donpivo/BluetoothToAmAdapter/Pictures/V2/02.jpg

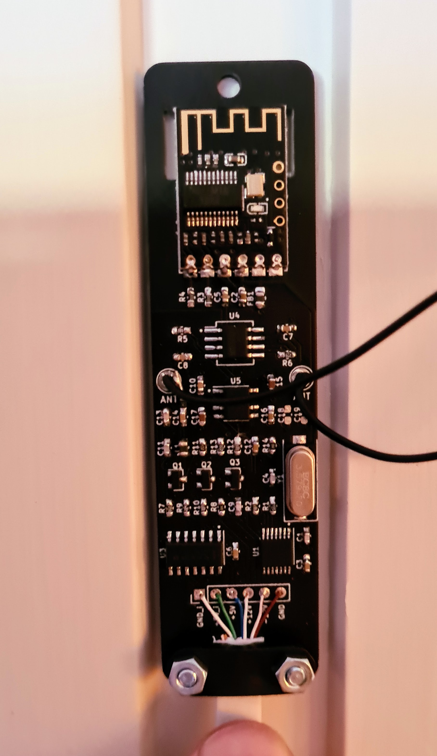
Pictures/V2/02.jpg
