donpivo/BluetoothToAmAdapter/Pictures/V2/6.jpg

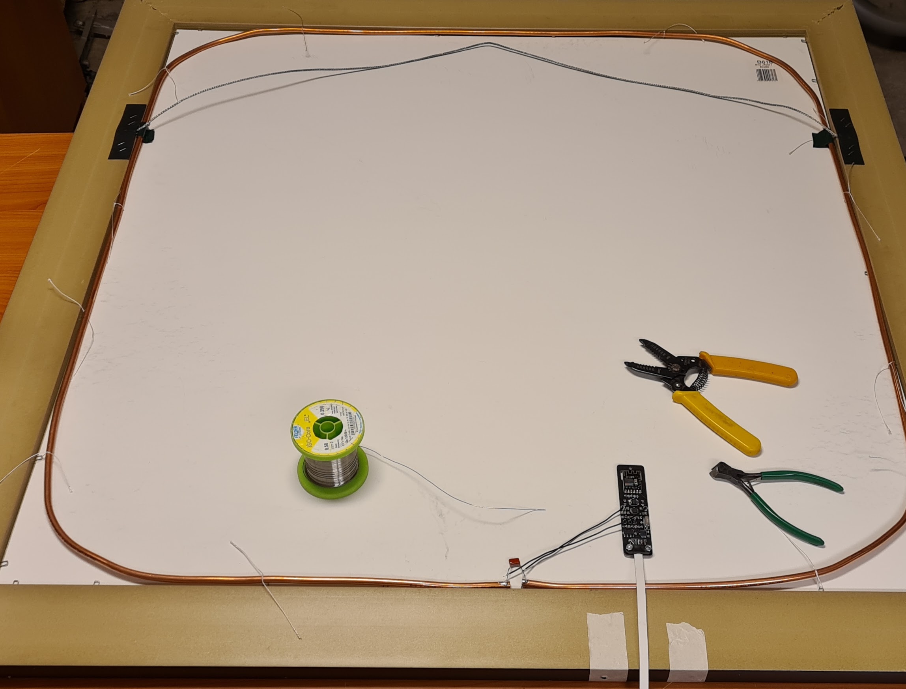
Pictures/V2/6.jpg
