donpivo/BluetoothToAmAdapter/Pictures/V2/01.jpg

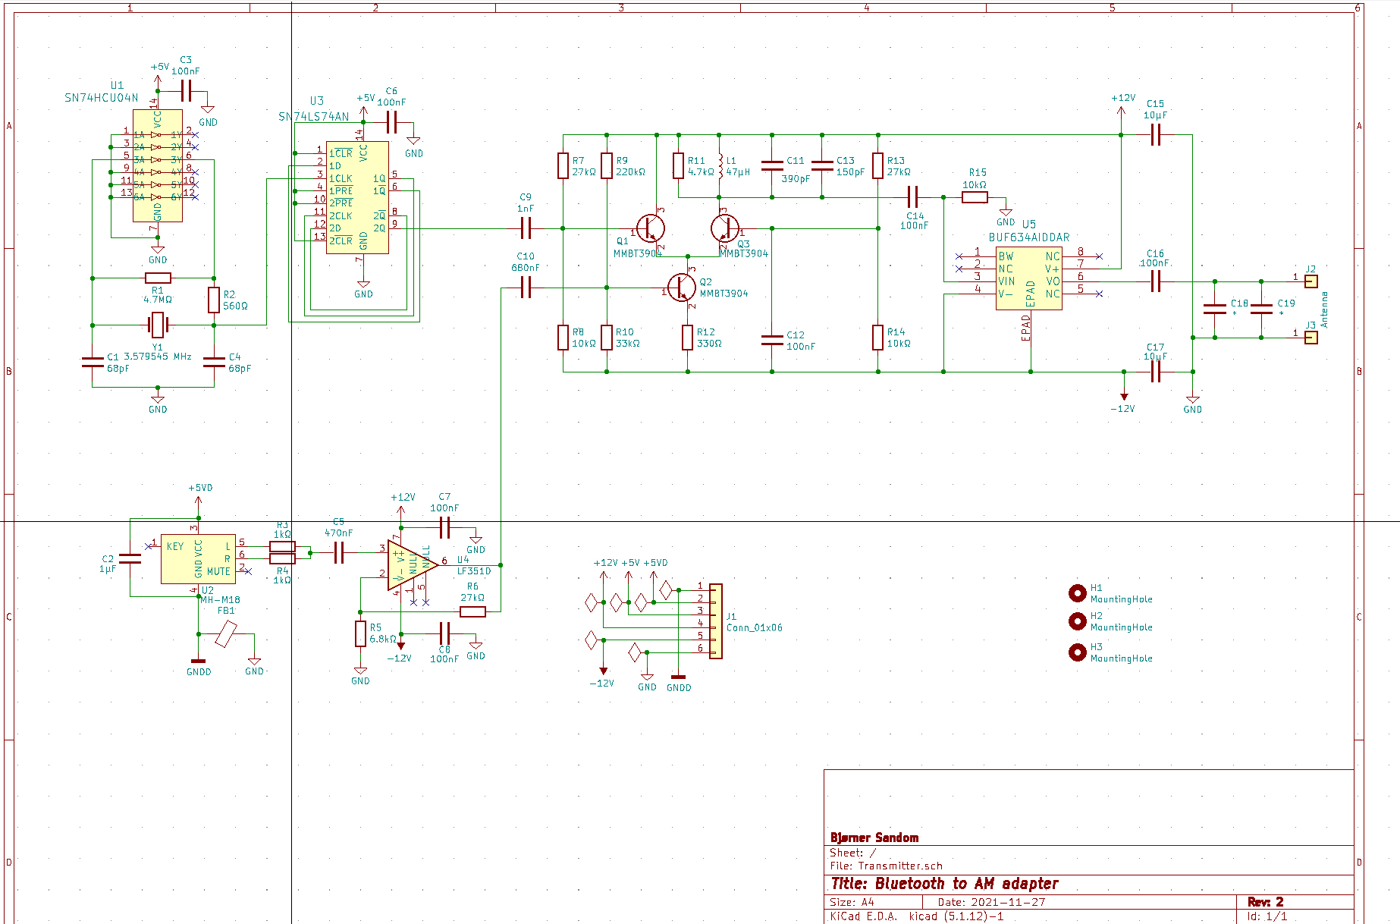
Pictures/V2/01.jpg
