donpivo/BluetoothToAmAdapter/Pictures/V2/03.jpg

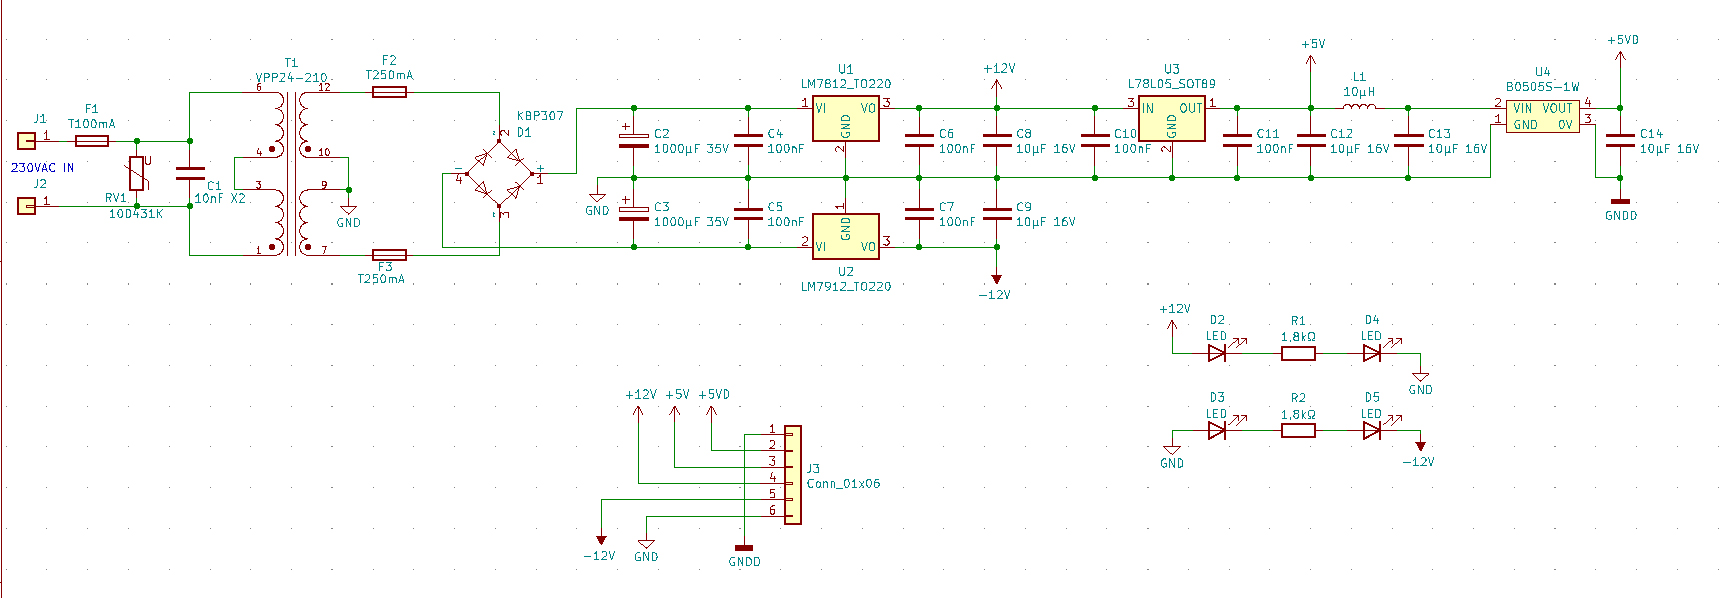
Pictures/V2/03.jpg
