donpivo/BluetoothToAmAdapter/Pictures/V2/04.jpg

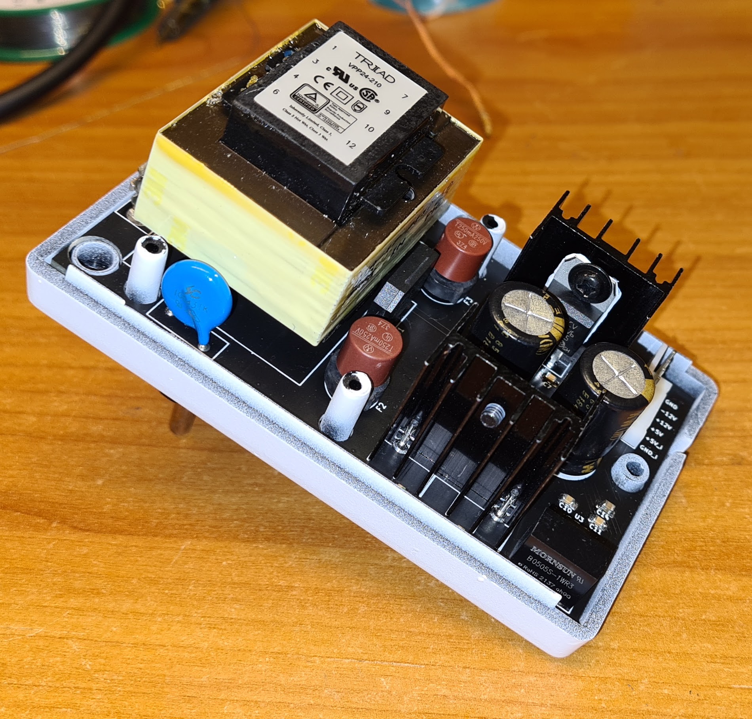
Pictures/V2/04.jpg
