donpivo/BluetoothToAmAdapter/Pictures/V2/5a.jpg

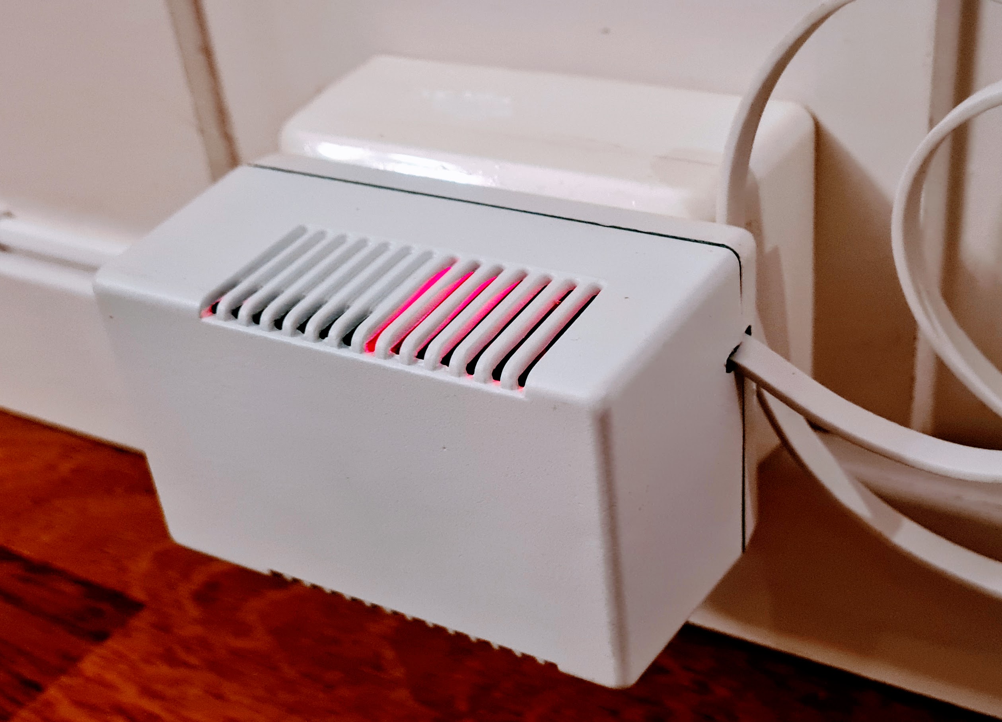
Pictures/V2/5a.jpg
