donpivo/BluetoothToAmAdapter/Pictures/V2/7.jpg

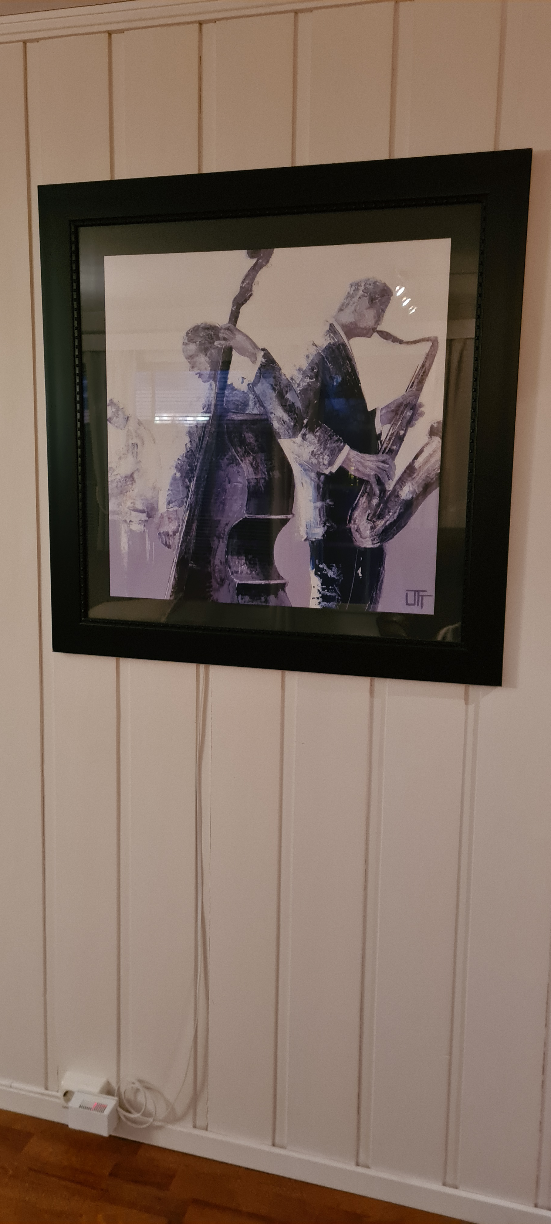
Pictures/V2/7.jpg
