donpivo/BluetoothToAmAdapter/Pictures/V2/07.jpg

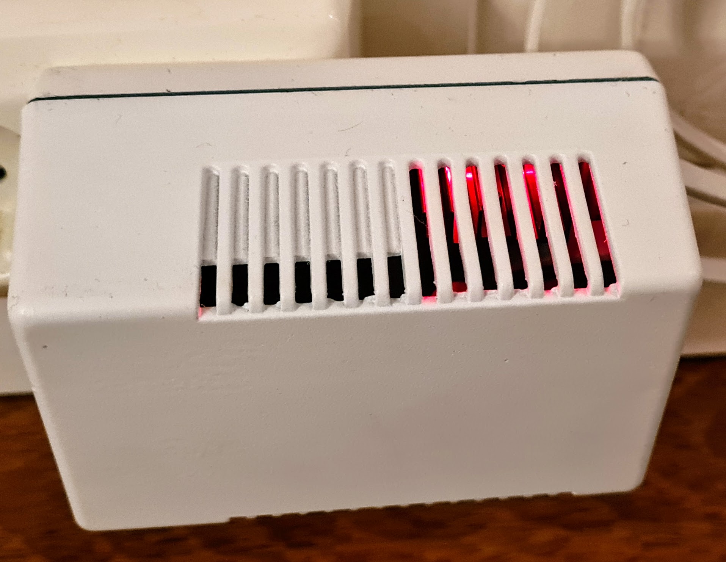
Pictures/V2/07.jpg
