donpivo/BluetoothToAmAdapter/Models/Lid.stl

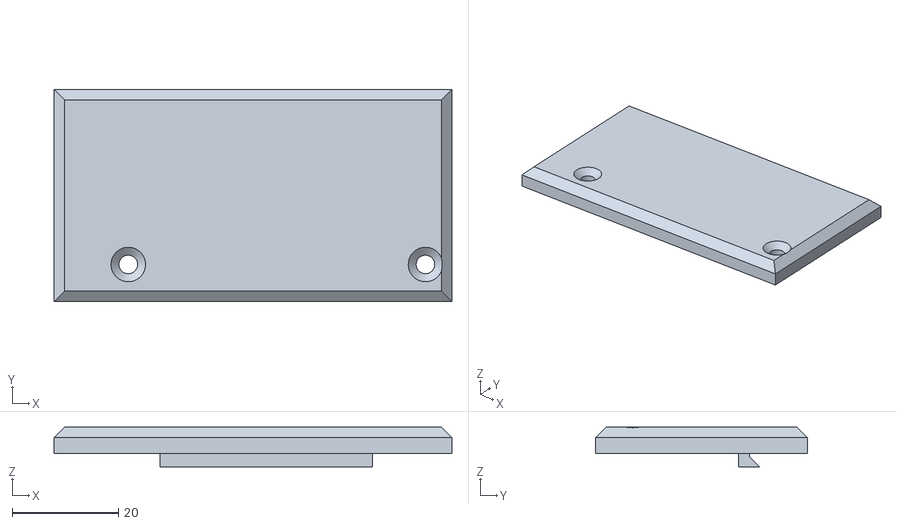
[picture p9: CAD file, 2021-11-08]
Models/Lid.stl
75.0 x 40.0 x 7.50
