donpivo/BluetoothToAmAdapter/Schematic/PSU/PSU.kicad_pcb

## KiCad design Schematic/PSU/PSU.kicad_pcb (2021-12-21)

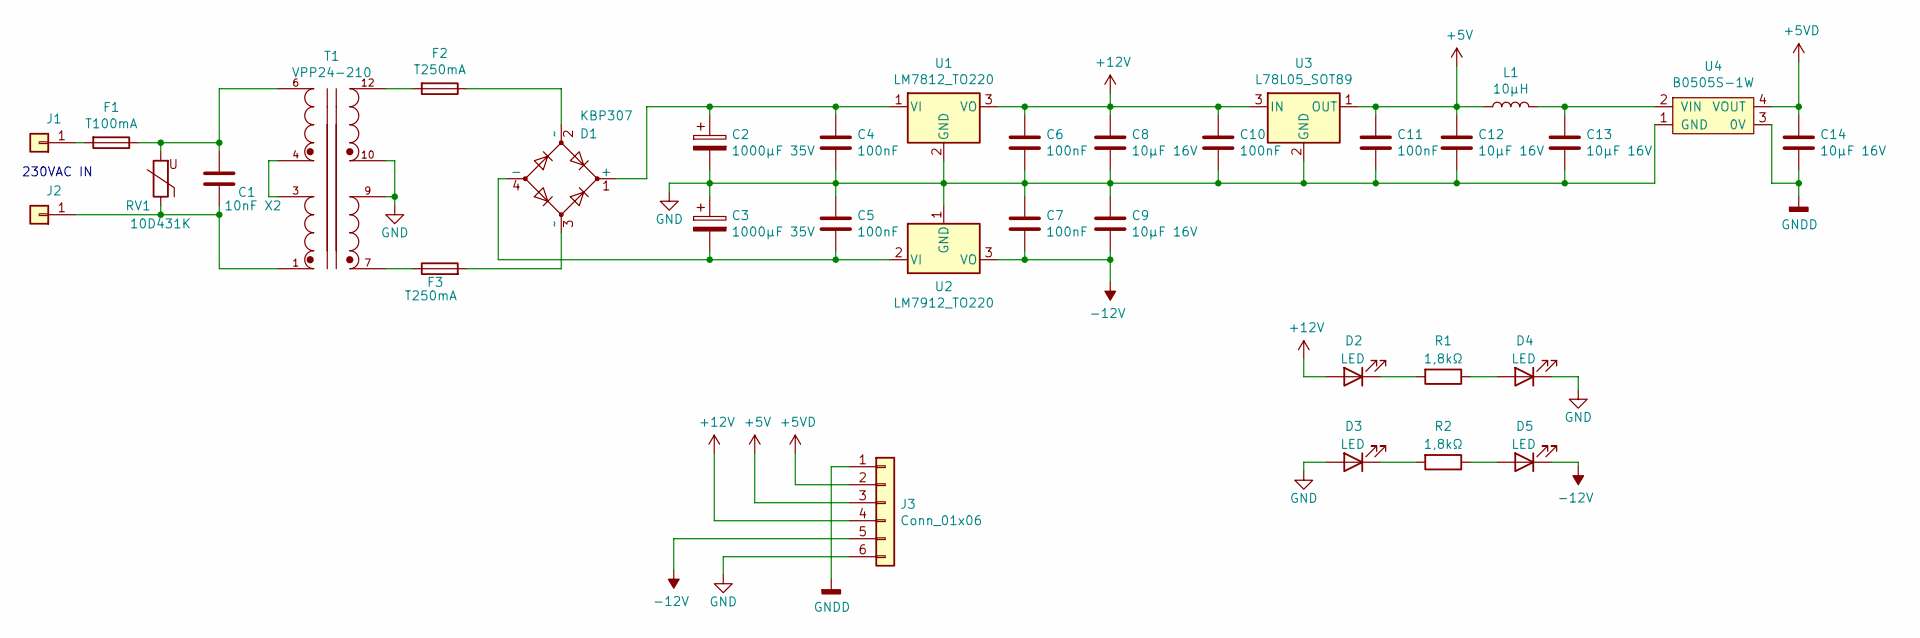
[picture p10: schematic PSU.sch, PSU - Dual + Digital]

Parts:
C1: 10nF X2; C_Rect_L10.3mm_W4.5mm_P7.50mm_MKS4
C2, C3: 1000µF 35V; CP_Radial_D12.5mm_P5.00mm
C4, C5, C6, C7, C10, C11: 100nF; C_0805_2012Metric_Pad1.18x1.45mm_HandSolder
C8, C9, C12, C13, C14: 10µF 16V; C_0805_2012Metric_Pad1.18x1.45mm_HandSolder
D1: KBP307; Rectifier_KBP307
D2, D3, D4, D5: LED; LED_0805_2012Metric_Pad1.15x1.40mm_HandSolder
F1: T100mA; Fuse_Littelfuse_372_D8.50mm
F2, F3: T250mA; Fuse_Littelfuse_372_D8.50mm
J1, J2: Conn_01x01; Pad_7mm
J3: Conn_01x06; KF2510-6P
L1: 10µH; L_0805_2012Metric_Pad1.15x1.40mm_HandSolder
R1, R2: 1,8kΩ; R_0805_2012Metric_Pad1.20x1.40mm_HandSolder
RV1: 10D431K; RV_Disc_D12mm_W4.3mm_P7.5mm
T1: VPP24-210; Transformer_XFMR_VPP24-210
U1: LM7812_TO220; TO-220-3_Heatsink1
U2: LM7912_TO220; TO-220-3_Heatsink1
U3: L78L05_SOT89; SOT-89-3
U4: B0505S-1W; B0505S

Connections:
+5V: C11.1, C12.1, J3.3, L1.1, U3.1 (OUT)
+5VD: C14.1, J3.2, U4.4 (VOUT)
+12V: C6.1, C8.1, C10.1, D2.2 (A), J3.4, U1.3 (VO), U3.3 (IN)
-12V: C7.2, C9.2, D5.1 (K), J3.5, U2.3 (VO)
GND: C2.2, C3.1, C4.2, C5.1, C6.2, C7.1, C8.2, C9.1, C10.2, C11.2, C12.2, C13.2, D3.2 (A), D4.1 (K), J3.6, T1.9, T1.10, U1.2 (GND), U2.1 (GND), U3.2 (GND), U4.1 (GND)
GNDD: C14.2, J3.1, U4.3 (0V)
unnamed: C1.1, F1.1, RV1.2, T1.6
unnamed: C1.2, J2.1, RV1.1, T1.1
unnamed: C2.1, C4.1, D1.1 (+), U1.1 (VI)
unnamed: C3.2, C5.2, D1.4 (-), U2.2 (VI)
unnamed: C13.1, L1.2, U4.2 (VIN)
unnamed: D1.2 (~~), F2.1
unnamed: D1.3 (~~), F3.2
unnamed: D2.1 (K), R1.2
unnamed: D3.1 (K), R2.2
unnamed: D4.2 (A), R1.1
unnamed: D5.2 (A), R2.1
unnamed: F1.2, J1.1
unnamed: F2.2, T1.12
unnamed: F3.1, T1.7
unnamed: T1.3, T1.4

Notes on the sheet:
230VAC IN

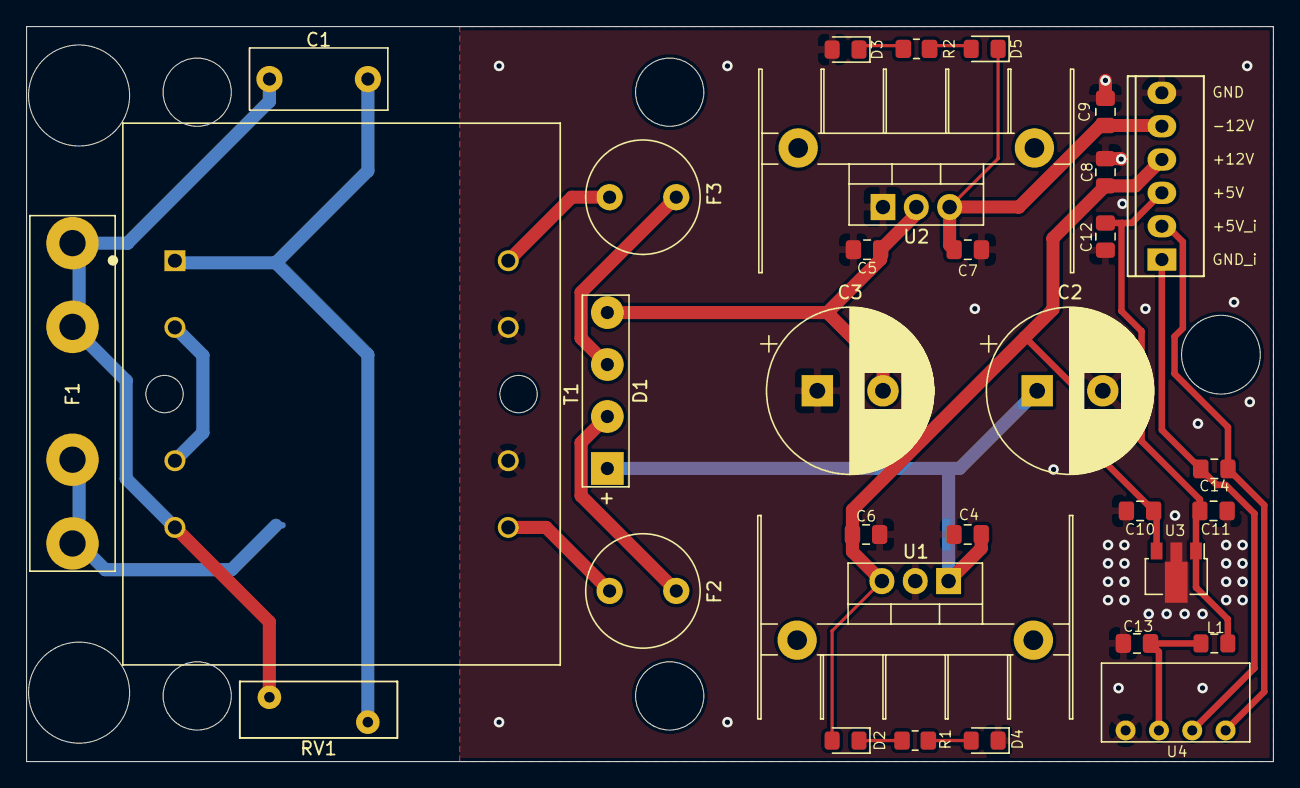
[picture p11: board PSU.kicad_pcb from above]

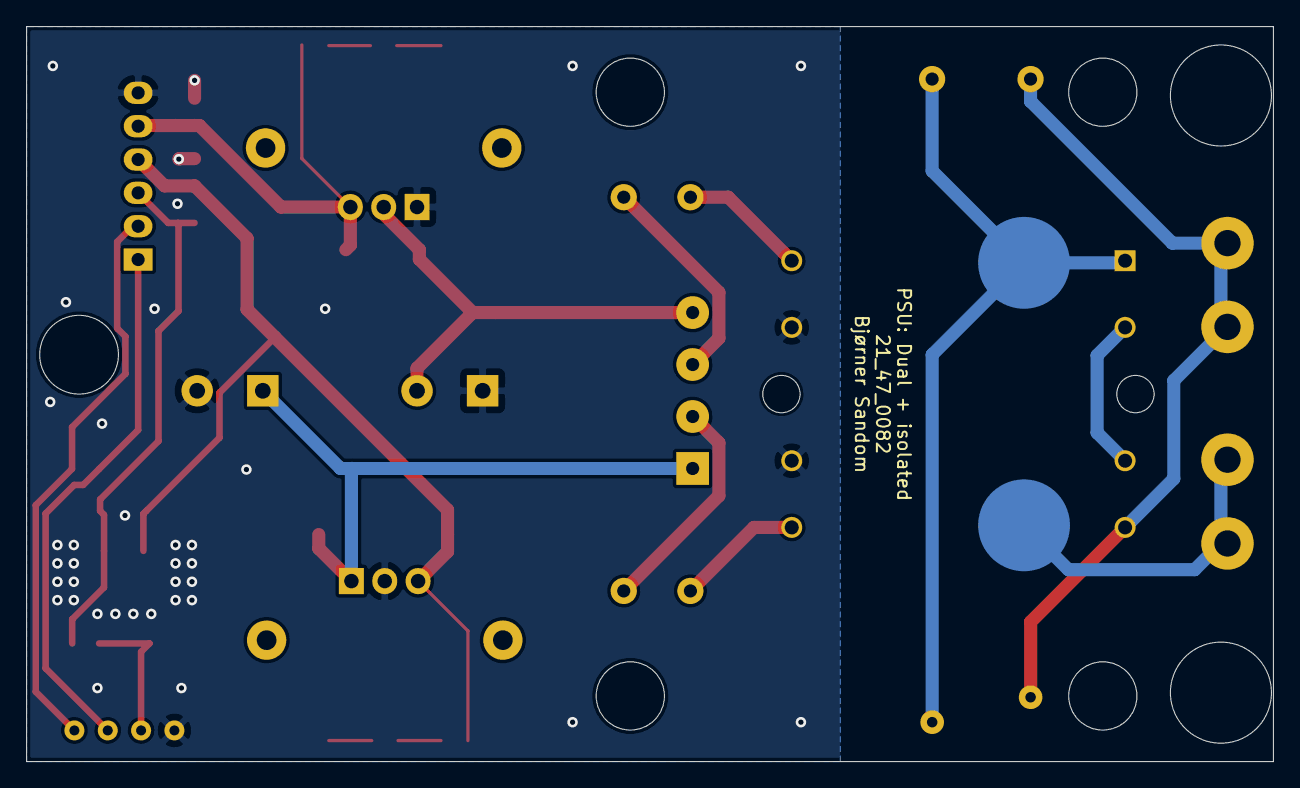
[picture p12: board PSU.kicad_pcb from below]

Board: 2 copper layers, 95.0 x 56.0 mm, 34 parts (2 on the bottom side), 21 nets.
