donpivo/BluetoothToAmAdapter/Schematic/Transmitter2/Transmitter.kicad_pcb

## KiCad design Schematic/Transmitter2/Transmitter.kicad_pcb (2021-12-21)

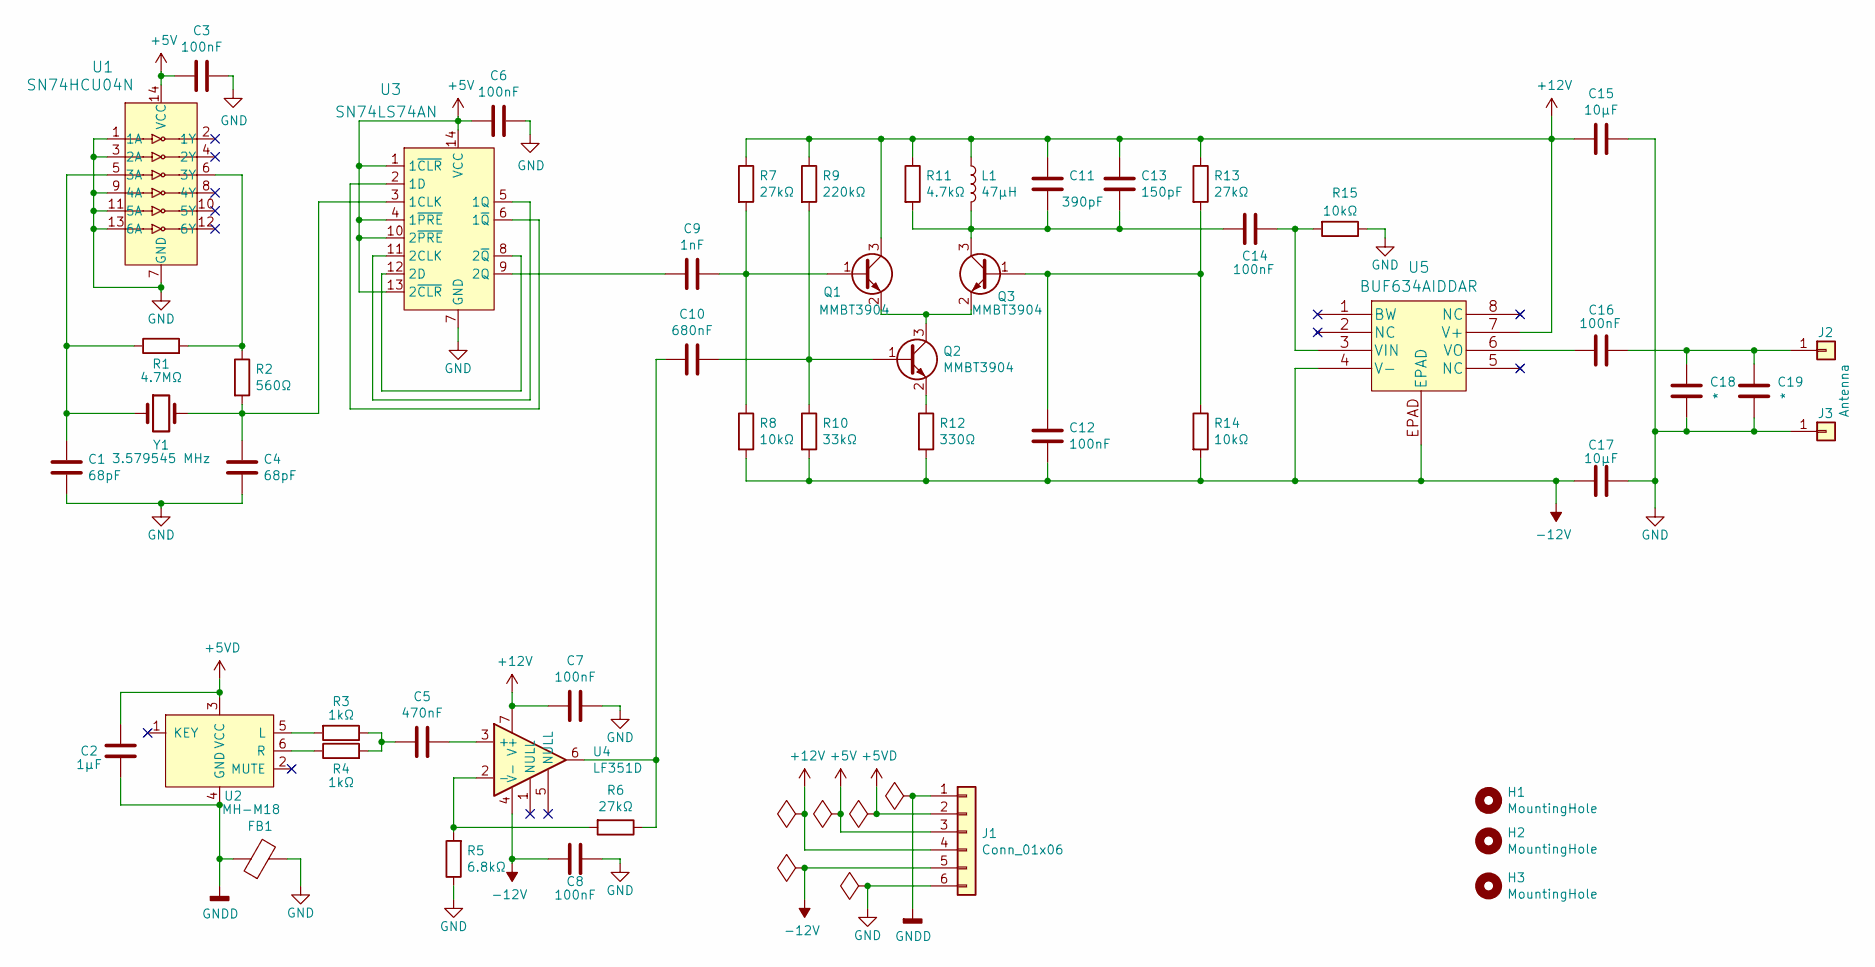
[picture p13: schematic Transmitter.sch, Bluetooth to AM adapter]

Parts:
C1, C4: 68pF; C_0603_1608Metric_Pad1.08x0.95mm_HandSolder
C2: 1µF; C_0603_1608Metric_Pad1.08x0.95mm_HandSolder
C3, C6, C7, C8, C12, C14, C16: 100nF; C_0603_1608Metric_Pad1.08x0.95mm_HandSolder
C5: 470nF; C_0603_1608Metric_Pad1.08x0.95mm_HandSolder
C9: 1nF; C_0603_1608Metric_Pad1.08x0.95mm_HandSolder
C10: 680nF; C_0603_1608Metric_Pad1.08x0.95mm_HandSolder
C11: 390pF; C_0603_1608Metric_Pad1.08x0.95mm_HandSolder
C13: 150pF; C_0603_1608Metric_Pad1.08x0.95mm_HandSolder
C15, C17: 10µF; C_0603_1608Metric_Pad1.08x0.95mm_HandSolder
C18, C19: *; C_0603_1608Metric_Pad1.08x0.95mm_HandSolder
FB1: Ferrite_Bead; L_0805_2012Metric_Pad1.15x1.40mm_HandSolder
H1, H2, H3: MountingHole; MountingHole_3.2mm_M3
J1: Conn_01x06; PinHeader_1x06_P2.54mm_Vertical
J2: Antenna; Pin_D1.3mm_L11.0mm_LooseFit
J3: Conn_01x01; Pin_D1.3mm_L11.0mm_LooseFit
L1: 47µH; L_0805_2012Metric_Pad1.15x1.40mm_HandSolder
Q1, Q2, Q3: MMBT3904; SOT-23
R1: 4.7MΩ; R_0603_1608Metric_Pad1.05x0.95mm_HandSolder
R2: 560Ω; R_0603_1608Metric_Pad1.05x0.95mm_HandSolder
R3, R4: 1kΩ; R_0603_1608Metric_Pad1.05x0.95mm_HandSolder
R5: 6.8kΩ; R_0603_1608Metric_Pad1.05x0.95mm_HandSolder
R6, R7, R13: 27kΩ; R_0603_1608Metric_Pad1.05x0.95mm_HandSolder
R8, R14, R15: 10kΩ; R_0603_1608Metric_Pad1.05x0.95mm_HandSolder
R9: 220kΩ; R_0603_1608Metric_Pad1.05x0.95mm_HandSolder
R10: 33kΩ; R_0603_1608Metric_Pad1.05x0.95mm_HandSolder
R11: 4.7kΩ; R_0603_1608Metric_Pad1.05x0.95mm_HandSolder
R12: 330Ω; R_0603_1608Metric_Pad1.05x0.95mm_HandSolder
U1: SN74HCU04N; TSSOP-14_4.4x5mm_P0.65mm; MPN SN74HC04N; Digi-Key_PN 296-1566-5-ND
U2: MH-M18
U3: SN74LS74AN; SOIC-14_3.9x8.7mm_P1.27mm; MPN SN74LS74AN; Digi-Key_PN 296-1668-5-ND
U4: LF351D; SO-8_5.3x6.2mm_P1.27mm
U5: BUF634AIDDAR; SOIC-8-1EP_3.9x4.9mm_P1.27mm_EP2.514x3.2mm_ThermalVias
Y1: 3.579545 MHz; Crystal_SMD_HC49-SD

Connections:
+5V: C3.2, C6.2, J1.3, U1.14 (VCC), U3.1 (1~CLR), U3.4 (1~PRE), U3.10 (2~PRE), U3.13 (2~CLR), U3.14 (VCC)
+5VD: C2.1, J1.2, U2.3 (VCC)
+12V: C7.2, C11.1, C13.1, C15.2, J1.4, L1.1, Q1.3 (C), R7.1, R9.1, R11.1, R13.1, U4.7 (V+), U5.7 (V+)
-12V: C8.2, C12.2, C17.2, J1.5, R8.2, R10.2, R12.2, R14.2, U4.4 (V-), U5.4 (V-), U5.EPAD
GND: C1.2, C3.1, C4.2, C6.1, C7.1, C8.1, C15.1, C17.1, C18.2, C19.2, FB1.2, J1.6, J3.1, R5.1, R15.1, U1.1 (1A), U1.3 (2A), U1.7 (GND), U1.9 (4A), U1.11 (5A), U1.13 (6A), U3.7 (GND)
GNDD: C2.2, FB1.1, J1.1, U2.4 (GND)
unnamed: C1.1, R1.1, U1.5 (3A), Y1.1
unnamed: C4.1, R2.2, U3.3 (1CLK), Y1.2
unnamed: C5.1, U4.3 (+)
unnamed: C5.2, R3.1, R4.2
unnamed: C9.1, Q1.1 (B), R7.2, R8.1
unnamed: C9.2, U3.9 (2Q)
unnamed: C10.1, Q2.1 (B), R9.2, R10.1
unnamed: C10.2, R6.1, U4.6
unnamed: C11.2, C13.2, C14.2, L1.2, Q3.3 (C), R11.2
unnamed: C12.1, Q3.1 (B), R13.2, R14.1
unnamed: C14.1, R15.2, U5.3 (VIN)
unnamed: C16.1, C18.1, C19.1, J2.1
unnamed: C16.2, U5.6 (VO)
unnamed: Q1.2 (E), Q2.3 (C), Q3.2 (E)
unnamed: Q2.2 (E), R12.1
unnamed: R1.2, R2.1, U1.6 (3Y)
unnamed: R3.2, U2.5 (L)
unnamed: R4.1, U2.6 (R)
unnamed: R5.2, R6.2, U4.2 (-)
unnamed: U3.2 (1D), U3.6 (1~Q)
unnamed: U3.5 (1Q), U3.11 (2CLK)
unnamed: U3.8 (2~Q), U3.12 (2D)

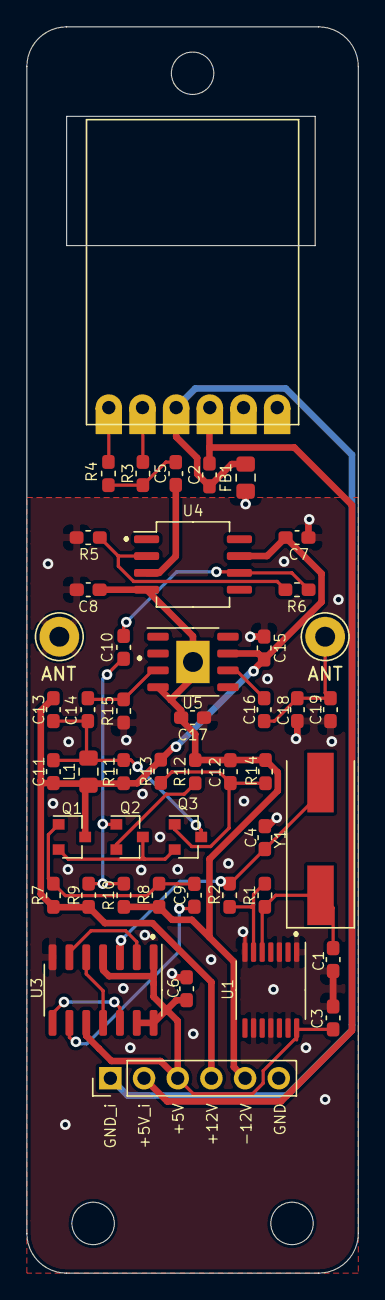
[picture p14: board Schematic/Transmitter2/Transmitter.kicad_pcb from above]

Board: 2 copper layers, 25.0 x 94.0 mm, 51 parts (0 on the bottom side), 28 nets.
