donpivo/BluetoothToAmAdapter/Schematic/Transmitter/Transmitter.kicad_pcb

## KiCad design Schematic/Transmitter/Transmitter.kicad_pcb (2021-11-08)

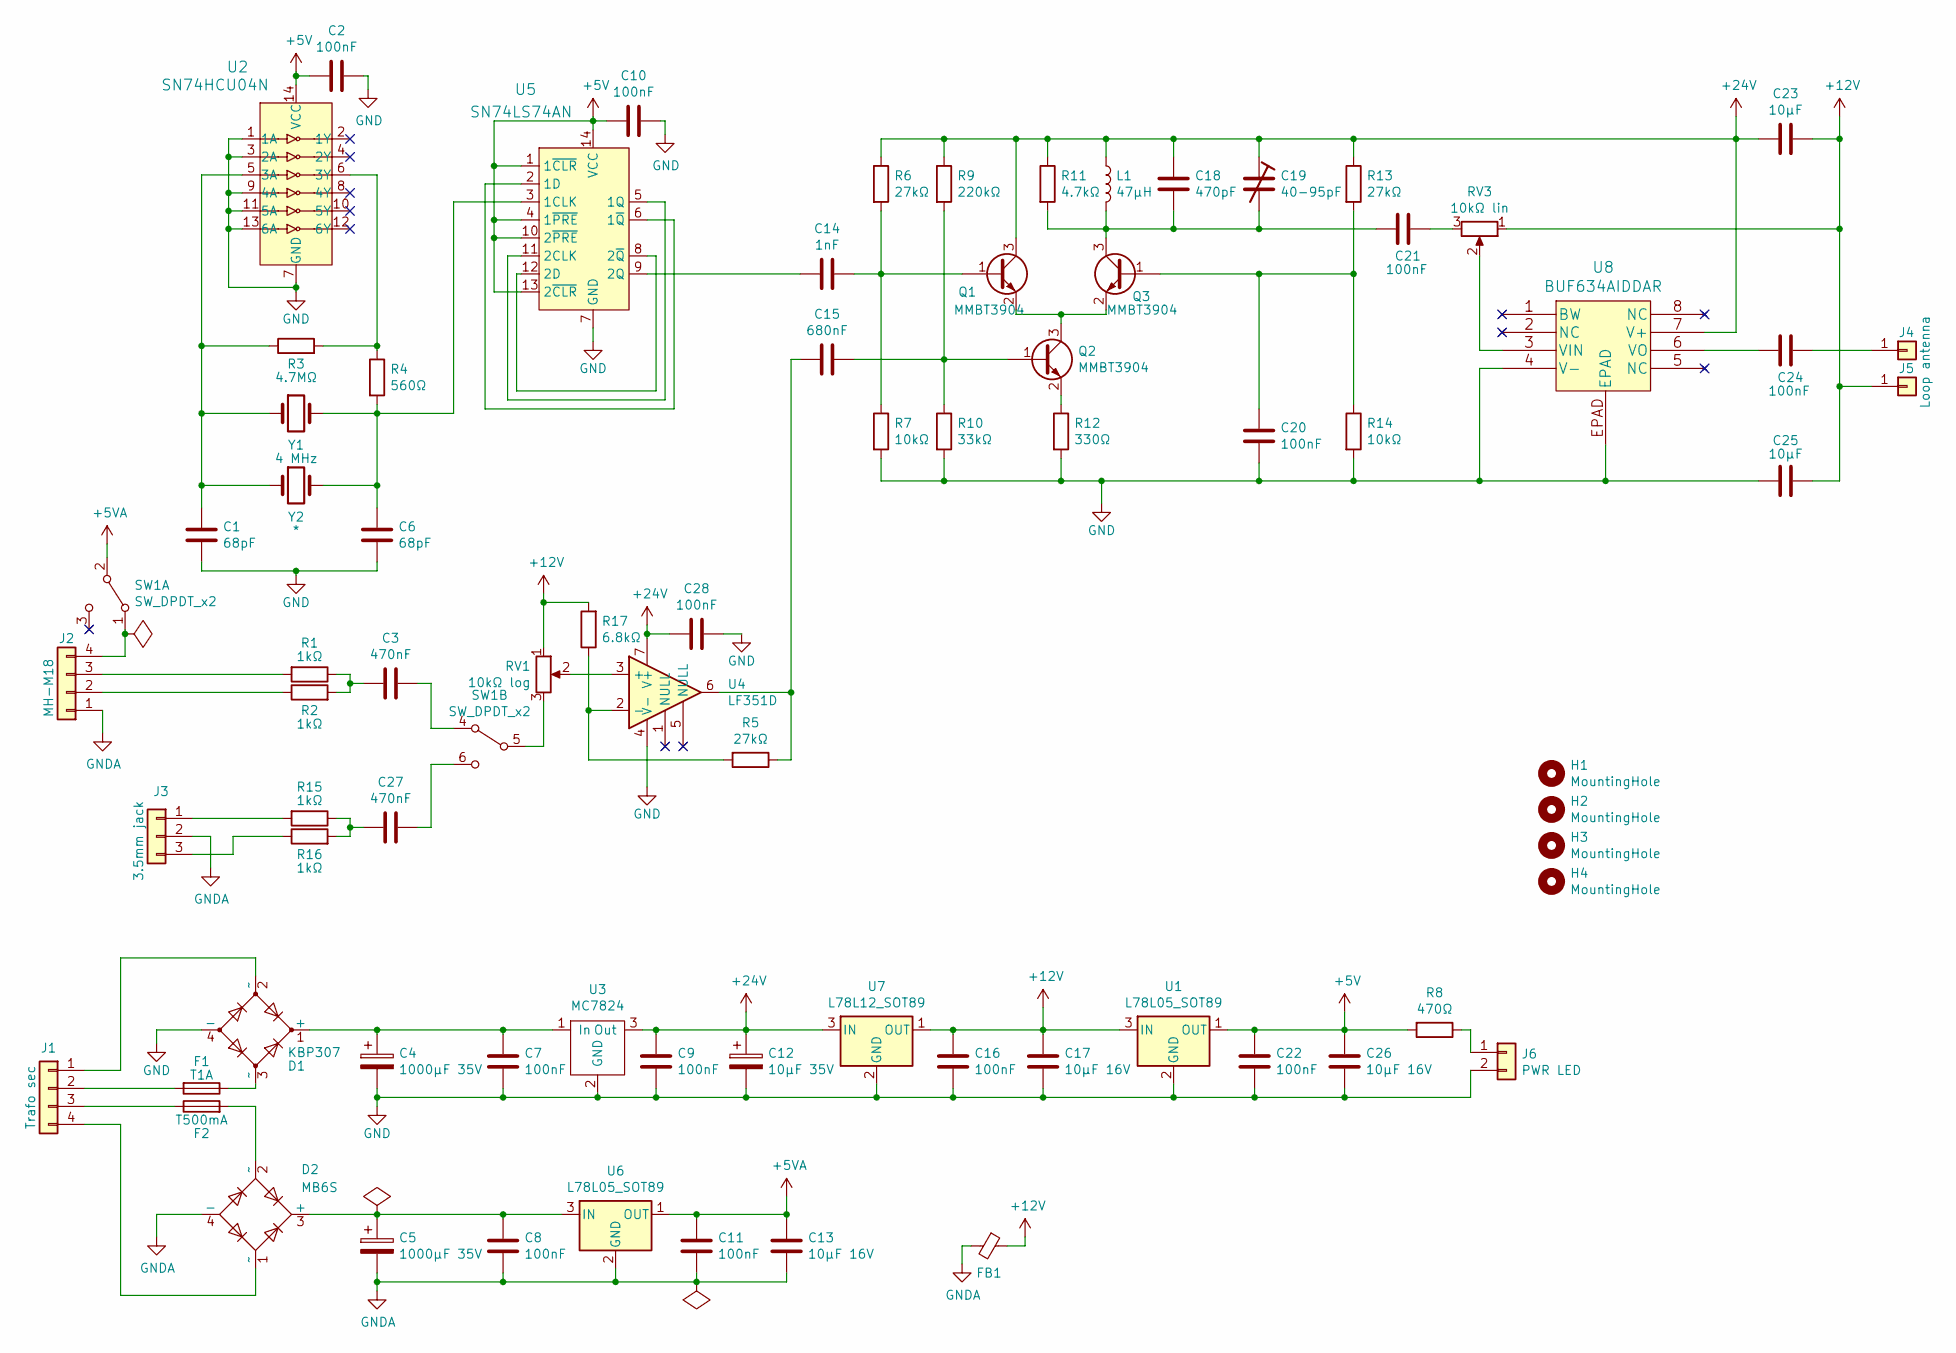
[picture p15: schematic Transmitter.sch, Bluetooth to AM adapter]

Parts:
C1, C6: 68pF; C_0603_1608Metric_Pad1.08x0.95mm_HandSolder
C2, C7, C8, C9, C10, C11, C16, C20, C21, C22, C24, C28: 100nF; C_0603_1608Metric_Pad1.08x0.95mm_HandSolder
C3, C27: 470nF; C_0603_1608Metric_Pad1.08x0.95mm_HandSolder
C4, C5: 1000µF 35V; CP_Radial_D12.5mm_P5.00mm
C12: 10µF 35V; CP_Elec_4x5.4
C13, C17, C26: 10µF 16V; C_0603_1608Metric_Pad1.08x0.95mm_HandSolder
C14: 1nF; C_0603_1608Metric_Pad1.08x0.95mm_HandSolder
C15: 680nF; C_0603_1608Metric_Pad1.08x0.95mm_HandSolder
C18: 470pF; C_0603_1608Metric_Pad1.08x0.95mm_HandSolder
C19: 40-95pF; Trimmer_cap_THT_7mm
C23, C25: 10µF; C_0603_1608Metric_Pad1.08x0.95mm_HandSolder
D1: KBP307; Rectifier_KBP307
D2: MB6S; TO-269AA
F1: T1A; Fuse_Littelfuse_372_D8.50mm
F2: T500mA; Fuse_Littelfuse_372_D8.50mm
FB1: Ferrite_Bead_Small; L_0805_2012Metric_Pad1.15x1.40mm_HandSolder
H1, H2, H3, H4: MountingHole; MountingHole_3.2mm_M3
J1: Trafo sec; KF2510-4P
J2: MH-M18; PinHeader_1x04_P2.54mm_Vertical
J3: 3.5mm jack; KF2510-3P
J4: Loop antenna; Pin_D1.3mm_L11.0mm_LooseFit
J5: Conn_01x01; Pin_D1.3mm_L11.0mm_LooseFit
J6: PWR LED; PinHeader_1x02_P2.54mm_Vertical
L1: 47µH; L_0805_2012Metric_Pad1.15x1.40mm_HandSolder
Q1, Q2, Q3: MMBT3904; SOT-23
R1, R2, R15, R16: 1kΩ; R_0603_1608Metric_Pad1.05x0.95mm_HandSolder
R3: 4.7MΩ; R_0603_1608Metric_Pad1.05x0.95mm_HandSolder
R4: 560Ω; R_0603_1608Metric_Pad1.05x0.95mm_HandSolder
R5, R6, R13: 27kΩ; R_0603_1608Metric_Pad1.05x0.95mm_HandSolder
R7, R14: 10kΩ; R_0603_1608Metric_Pad1.05x0.95mm_HandSolder
R8: 470Ω; R_0603_1608Metric_Pad1.05x0.95mm_HandSolder
R9: 220kΩ; R_0603_1608Metric_Pad1.05x0.95mm_HandSolder
R10: 33kΩ; R_0603_1608Metric_Pad1.05x0.95mm_HandSolder
R11: 4.7kΩ; R_0603_1608Metric_Pad1.05x0.95mm_HandSolder
R12: 330Ω; R_0603_1608Metric_Pad1.05x0.95mm_HandSolder
R17: 6.8kΩ; R_0603_1608Metric_Pad1.05x0.95mm_HandSolder
RV1: 10kΩ log; Potentiometer_Alps_RK163_Single_Horizontal
RV3: 10kΩ lin; Potentiometer_Alps_RK163_Single_Horizontal
SW1: SW_DPDT_x2; Toggle_sw_submin
U1, U6: L78L05_SOT89; SOT-89-3
U2: SN74HCU04N; TSSOP-14_4.4x5mm_P0.65mm; MPN SN74HC04N; Digi-Key_PN 296-1566-5-ND
U3: MC7824; TO-263-2
U4: LF351D; SO-8_5.3x6.2mm_P1.27mm
U5: SN74LS74AN; SOIC-14_3.9x8.7mm_P1.27mm; MPN SN74LS74AN; Digi-Key_PN 296-1668-5-ND
U7: L78L12_SOT89; SOT-89-3
U8: BUF634AIDDAR; SOIC-8-1EP_3.9x4.9mm_P1.27mm_EP2.514x3.2mm_ThermalVias
Y1: 4 MHz; Crystal_HC49-U_Vertical
Y2: *; Crystal_SMD_HC49-SD

Connections:
+5V: C2.2, C10.2, C22.1, C26.1, R8.2, U1.1 (OUT), U2.14 (VCC), U5.1 (1~CLR), U5.4 (1~PRE), U5.10 (2~PRE), U5.13 (2~CLR), U5.14 (VCC)
+5VA: C11.1, C13.1, SW1.2 (B), U6.1 (OUT)
+12V: C16.1, C17.1, C23.1, C25.1, FB1.1, J5.1, R17.2, RV1.1, RV3.1, U1.3 (IN), U7.1 (OUT)
+24V: C9.1, C12.1, C18.1, C19.1, C23.2, C28.2, L1.1, Q1.3 (C), R6.1, R9.1, R11.1, R13.1, U3.3 (Out), U4.7 (V+), U7.3 (IN), U8.7 (V+)
GND: C1.2, C2.1, C4.2, C6.2, C7.2, C9.2, C10.1, C12.2, C16.2, C17.2, C20.2, C22.2, C25.2, C26.2, C28.1, D1.4 (-), J6.2, R7.2, R10.2, R12.2, R14.2, U1.2 (GND), U2.1 (1A), U2.3 (2A), U2.7 (GND), U2.9 (4A), U2.11 (5A), U2.13 (6A), U3.2 (GND), U4.4 (V-), U5.7 (GND), U7.2 (GND), U8.4 (V-), U8.EPAD
GNDA: C5.2, C8.2, C11.2, C13.2, D2.4 (-), FB1.2, J2.1, J3.2, U6.2 (GND)
unnamed: C1.1, R3.1, U2.5 (3A), Y1.1, Y2.1
unnamed: C3.1, SW1.4 (A)
unnamed: C3.2, R1.1, R2.2
unnamed: C4.1, C7.1, D1.1 (+), U3.1 (In)
unnamed: C5.1, C8.1, D2.3 (+), U6.3 (IN)
unnamed: C6.1, R4.2, U5.3 (1CLK), Y1.2, Y2.2
unnamed: C14.1, Q1.1 (B), R6.2, R7.1
unnamed: C14.2, U5.9 (2Q)
unnamed: C15.1, Q2.1 (B), R9.2, R10.1
unnamed: C15.2, R5.1, U4.6
unnamed: C18.2, C19.2, C21.2, L1.2, Q3.3 (C), R11.2
unnamed: C20.1, Q3.1 (B), R13.2, R14.1
unnamed: C21.1, RV3.3
unnamed: C24.1, J4.1
unnamed: C24.2, U8.6 (VO)
unnamed: C27.1, SW1.6 (C)
unnamed: C27.2, R15.1, R16.2
unnamed: D1.2 (~~), J1.1
unnamed: D1.3 (~~), F1.1
unnamed: D2.1 (~~), J1.4
unnamed: D2.2 (~~), F2.2
unnamed: F1.2, J1.2
unnamed: F2.1, J1.3
unnamed: J2.2, R2.1
unnamed: J2.3, R1.2
unnamed: J2.4, SW1.1 (A)
unnamed: J3.1, R15.2
unnamed: J3.3, R16.1
unnamed: J6.1, R8.1
unnamed: Q1.2 (E), Q2.3 (C), Q3.2 (E)
unnamed: Q2.2 (E), R12.1
unnamed: R3.2, R4.1, U2.6 (3Y)
unnamed: R5.2, R17.1, U4.2 (-)
unnamed: RV1.2, U4.3 (+)
unnamed: RV1.3, SW1.5 (B)
unnamed: RV3.2, U8.3 (VIN)
unnamed: U5.2 (1D), U5.6 (1~Q)
unnamed: U5.5 (1Q), U5.11 (2CLK)
unnamed: U5.8 (2~Q), U5.12 (2D)

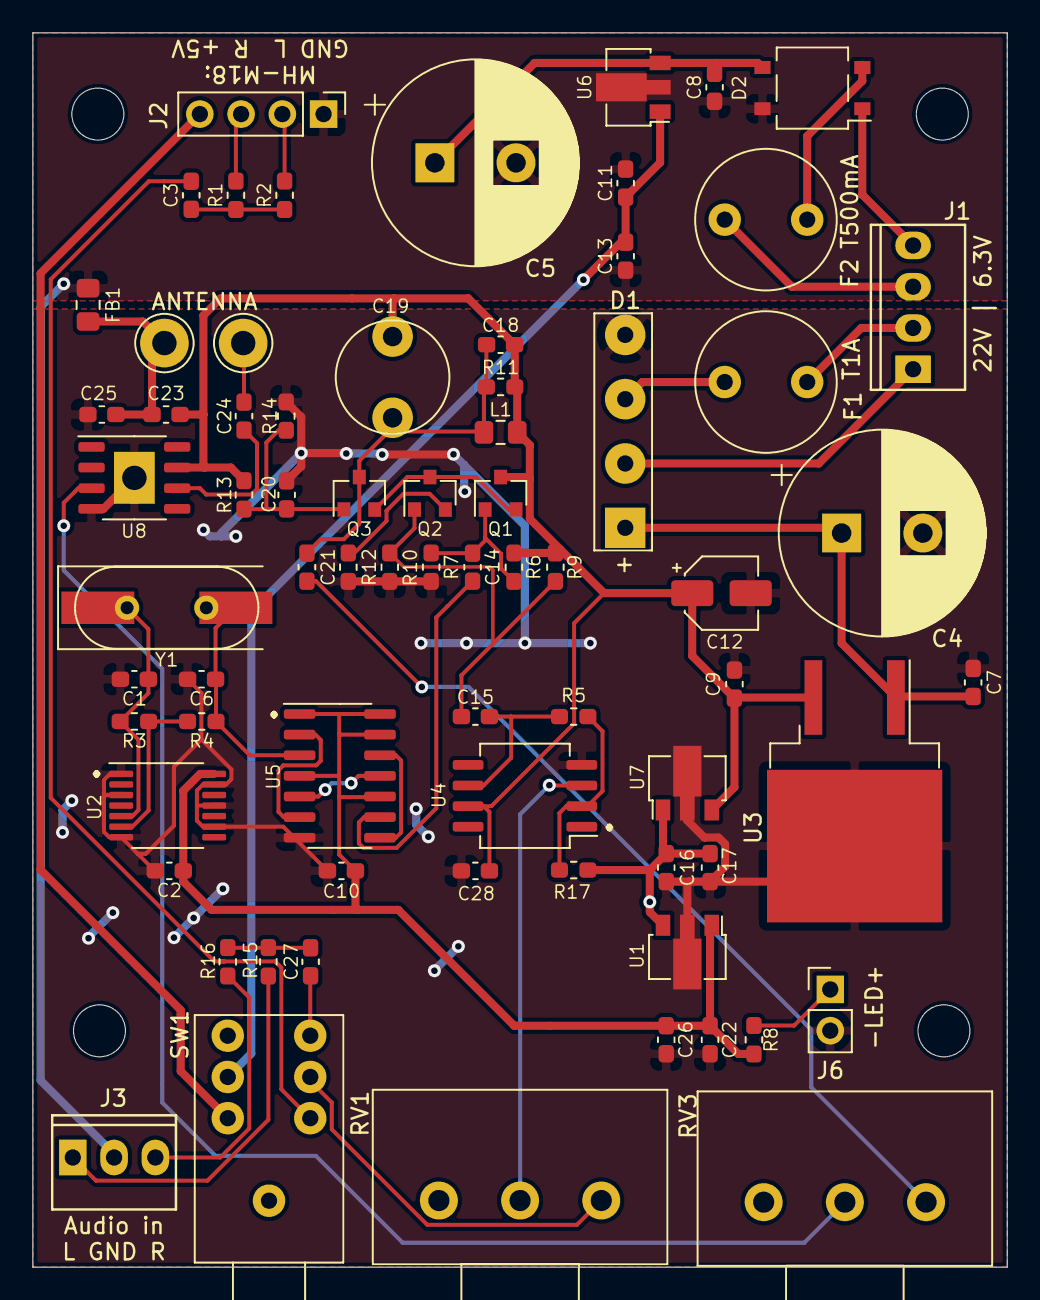
[picture p16: board Schematic/Transmitter/Transmitter.kicad_pcb from above]

Board: 2 copper layers, 60.0 x 76.0 mm, 77 parts (0 on the bottom side), 45 nets.
