donpivo/BluetoothToAmAdapter/(commit log)

2021-11-08 Created repository
    [Lid.stl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]
2021-11-26 New compact version with separate PSU
    [PSU-B_Cu.gbl, PSU-B_Mask.gbs, PSU-B_SilkS.gbo, PSU-Edge_Cuts.gm1, PSU-F_Cu.gtl, PSU-F_Mask.gts, PSU-F_SilkS.gto, PSU-NPTH.drl]
2021-12-21 Added missing resistor: R15
    [PSU.kicad_pcb, PSU.sch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]
